zhaowk-ustc/RoboGame2025/electric_control/REDAME/README.md

# 电控

本文件夹包含电控子模块代码（`ele_control`）和硬件文档（`RG_PCB`）

硬件（PCB）相关技术文档：`TECHNICAL.md`中的硬件模块部分。原理图，PCB，引脚，接口定义，电源管理，外部布线等内容。

电控代码技术文档：`TECHNICAL.md`中的代码结构部分。详细技术文档（模块说明、通信协议、API 使用示例、构建与调试注意事项）。
