zhaowk-ustc/RoboGame2025/(list of files, drawings)

Other design files:
electric_control/RG_PCB/PCB.eprj
electric_control/RG_PCB/STM32F767_F429_H743底板原理图_PCB.eprj
