zhaowk-ustc/RoboGame2025/(commit log)

2025-04-30 更新计划书
2025-04-30 主控换成tc264
2025-05-03 计划书.md
2025-05-06 完成计划书
    [经费预算.xlsx]
2025-08-11 修复空图像显示，修复linux系统摄像头调用
2025-08-11 修复linux无法开启高分辨率，更改摄像头界面刷新逻辑
2025-08-11 修复apriltag检测慢的问题
2025-08-11 忽视编译文件
2025-08-11 发射1.0
2025-08-11 更改电控的gitignore
2025-09-10 更改为正确的url
2025-09-13 增加电控代码
2025-09-13 添加发射函数
2025-09-13 惯性导航
2025-09-14 添加通信代码
2025-09-14 更新vision子模块到最新版本
2025-09-14 惯性导航修改
2025-09-14 简单修改
2025-09-15 不使用中断接收
2025-09-15 修改了串口通信的一些实现
2025-09-15 通信交互_执行部分
2025-09-15 更新了测试串口的主函数
2025-09-15 惯性导航消除初始化冲突，设置速度接口，添加推进停止
2025-09-15 添加gitignore
2025-09-15 更新子仓库
2025-09-15 修改底盘电机通道
2025-09-15 重排了变量列表
2025-09-15 更新通信变量
2025-09-16 push修改
2025-09-16 档位设置
2025-09-16 移动快慢调节
2025-09-16 加入缺少的break
2025-09-16 修改底盘参数
2025-09-17 参数修改
2025-09-17 直接到初始位置
2025-09-17 更新变量
2025-09-17 机械臂路径优化
2025-09-17 添加动作
2025-09-17 更正，提速
2025-09-17 加break
2025-09-17 更改位置参数
2025-09-17 参数调整
2025-09-17 更新机械臂实现
2025-09-17 发射角度映射，和机械臂参数调整
2025-09-17 更新变量；加入回发
2025-09-17 补充发射一次的动作
2025-09-18 加入陀螺仪相关通信
2025-09-18 解包数据
2025-09-18 修改陀螺仪相关实现
2025-09-18 更新了移动pwm值
2025-09-19 添加指令，调整参数
2025-09-19 修改映射
2025-09-19 移动参数
2025-09-19 初始化无刷
2025-09-19 左右参数调整
2025-09-19 移动参数调整
2025-09-19 前后移动减速
2025-09-19 三审封包
2025-09-20 陀螺仪信息传递
2025-09-20 修改参数
2025-09-25 加入arm_reset_to_store
2025-09-26 更新接口
2025-09-26 修复缺少的接口
2025-09-26 机械臂全流程，发射电压反馈，推进速度更改
2025-09-26 机械臂接口
2025-09-27 加入获取电压接口
2025-09-27 低位抓取参数调整，速度加快，电压接口
2025-09-27 摩擦轮逻辑
2025-09-27 改bug
2025-09-27 去除一些注释
2025-10-01 换舵机，改参数
2025-10-01 适配mg996参数
2025-10-02 更新参数
2025-10-03 改20kg舵机
2025-10-03 降低等待姿态
2025-10-10 电控技术总结
    [PCB.eprj, STM32F767_F429_H743底板原理图_PCB.eprj, protocol_vars.csv]
2025-11-05 赛季总结
