zhaowk-ustc/RoboGame2025/(notices)

Notices in the files:
electric_control/ele_control/user/cpu0_main.c:
Copyright (c) 2022 SEEKFREE Öð·É¿Æ¼¼
